mm-nair/Somnium/creative/previews/anime.jpg

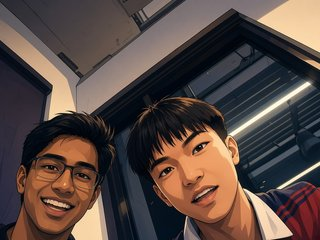
creative/previews/anime.jpg
