mm-nair/Somnium/creative/previews/comic.jpg

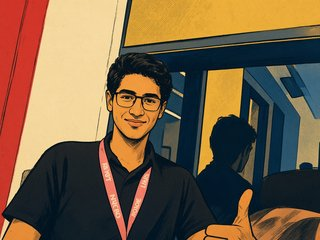
creative/previews/comic.jpg
