mm-nair/Somnium/creative/previews/pencil.jpg

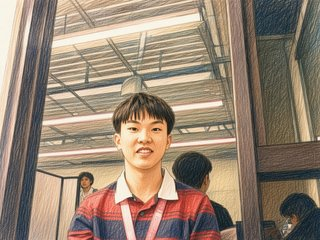
creative/previews/pencil.jpg
