mm-nair/Somnium/creative/previews/watercolor.jpg

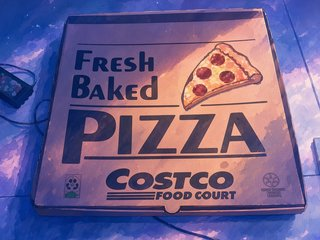
creative/previews/watercolor.jpg
