mm-nair/Somnium/somnium.gif

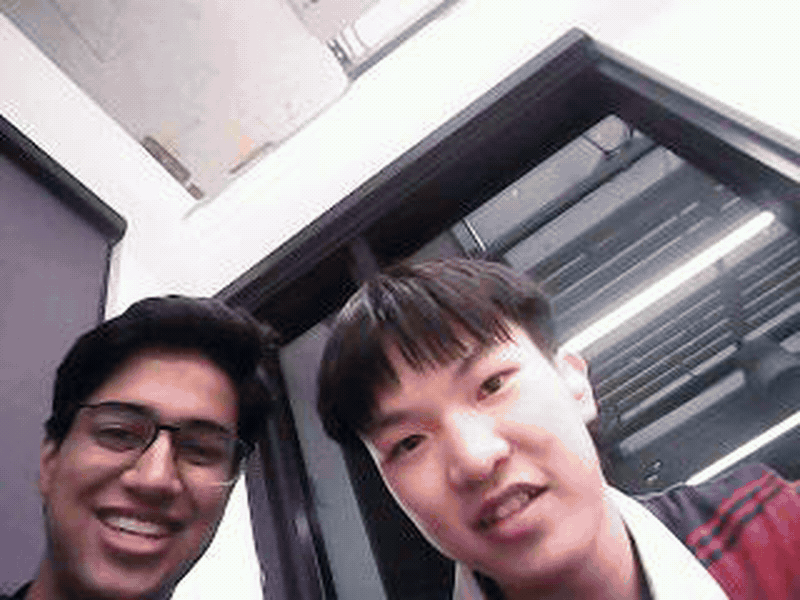
somnium.gif
