mm-nair/Somnium/cad/Front Panel.stl

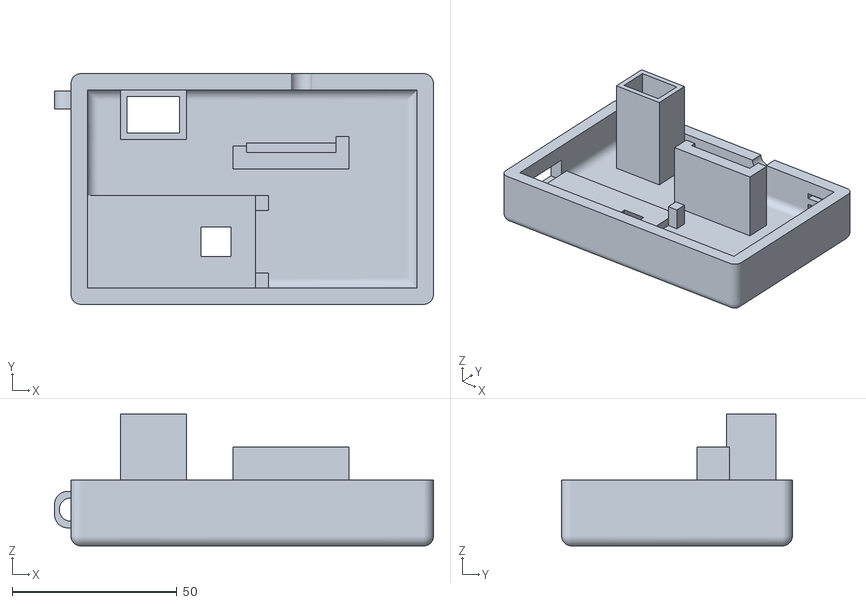
[picture p8: CAD file, 2026-10-18]
cad/Front Panel.stl
115.0 x 70.0 x 40.0
