mm-nair/Somnium/cad/Back Panel.stl

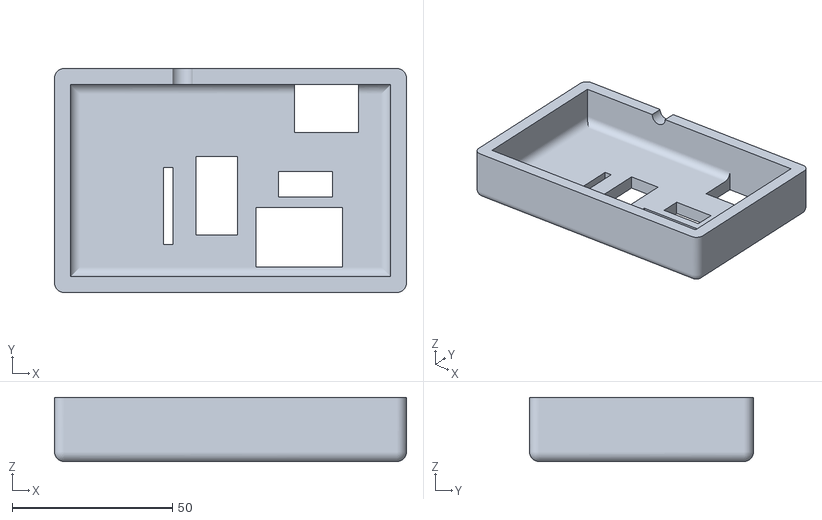
[picture p9: CAD file, 2026-10-18]
cad/Back Panel.stl
110.0 x 70.0 x 20.0
