mm-nair/Somnium/(commit log)

2026-10-18 Create Camera Case CAD files
2026-10-18 Added CAD Files
    [Back Panel.stl, Front Panel.stl]
2026-10-18 Streamlined Repo
    [Back Panel.stl, Front Panel.stl]
2026-10-18 Add optional gallery upload for saved camera shots.
    Post each shot after its metadata JSON is written when SOMNIUM_UPLOAD_URL and SOMNIUM_UPLOAD_TOKEN are set, and vendor the stdlib watcher as nix run .#uploader against server/outputs.
2026-10-20 Host the image server on Fly.io
    The cook is a multi-minute HTTP request that writes shots to disk and
    uploads them in the background, so it stays a long-running container
    instead of a Vercel function. Environment variables replace laptop
    paths, and a shared secret closes POST /v1/process on the public host.
    [test_remote_host.py, usb_bridge.py]
2026-10-20 Add Wi-Fi cook with optional HTTPS and a process token.
    The board can speak the existing COOK/DREAM framing over TCP on
    somnium.local:8090, or POST /v1/process itself when a server host is
    set. TLS and X-Somnium-Token are optional. skip_gallery keeps the
    camera and the server from uploading the same shot twice.
    [test_gallery_upload.py, test_http_format.py, test_process_errors.py, test_usb_bridge.py]
2026-10-20 Host the image server on Oracle Cloud Always Free
    Replace the Fly.io deploy with a $0 Always Free Ampere A1 setup:
    Compose, Caddy on 443, DuckDNS or sslip.io, and the existing process
    token. skip_gallery lets the Wi-Fi camera upload a shot itself.
    [test_gallery_upload.py, test_remote_host.py, usb_bridge.py]
2026-10-20 Fix Wi-Fi cook TLS, idle timeouts, and shared server docs.
    Verify Let's Encrypt ISRG roots instead of skipping certificate checks,
    sync the clock from NTP, and keep the TCP session alive for the 300s cook
    budget. A dropped Wi-Fi client fails the cook immediately. Bridge timeouts
    at or above 300s are capped so the laptop can still return ERR. Shared
    server docs now describe the Oracle host rather than Fly.
    [test_gallery_upload.py, test_http_format.py, test_usb_bridge.py, test_wifi_bridge.py, usb_bridge.py]
2026-10-20 Harden the Oracle host and line it up with the Wi-Fi branch.
    Caddy waits 360s for cook headers and sends Content-Length. Compose no longer copies the DuckDNS token into the app. The firewall script clears the FORWARD reject on iptables and iptables-legacy without saving Docker's chains, and the unit reapplies it on boot. A cook runs off the event loop so /health stays up, and the files both branches edit are now the same text.
    [test_canvas_flush.py, test_gallery_upload.py, test_remote_host.py, test_ui_text.py]
2026-10-29 Sleep the camera after 45 seconds without input.
    Deep sleep waits out capture, save, and transfer, then powers down the panel, sensor, SD, and radio. The shutter on GPIO3 wakes it back to the mode screen.
